Nobcha/R909-SINAD/C401_FFT@433MHz.jpg

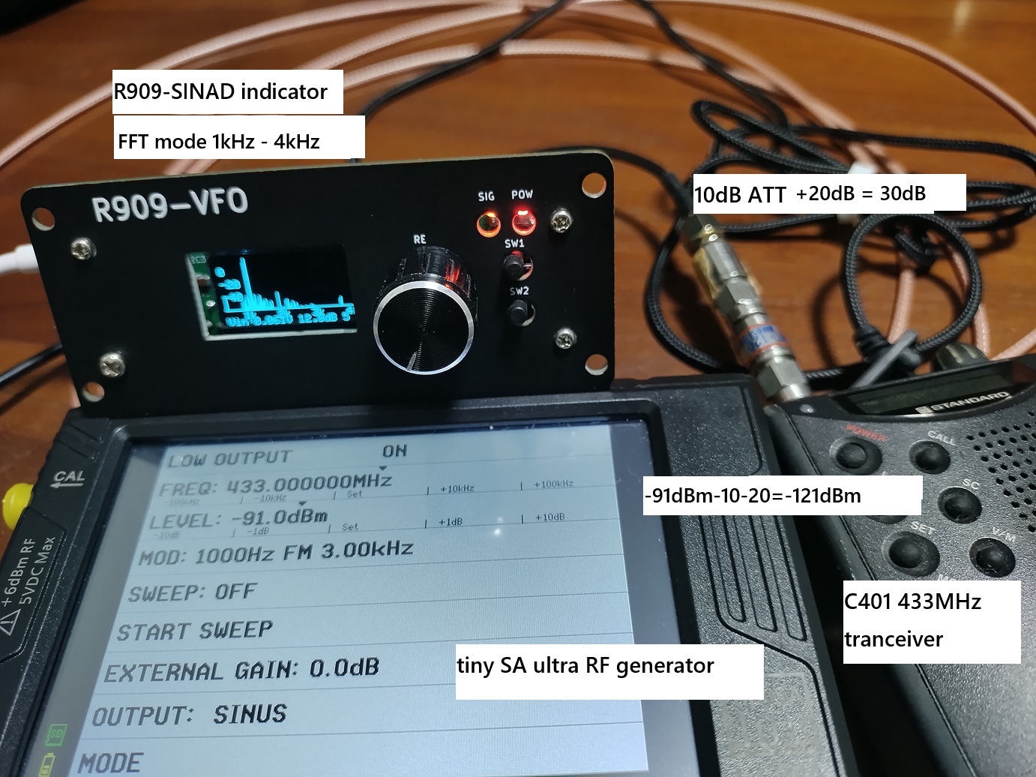
C401_FFT@433MHz.jpg
