Nobcha/R909-SINAD/C401_SINAD@433MHz_.jpg

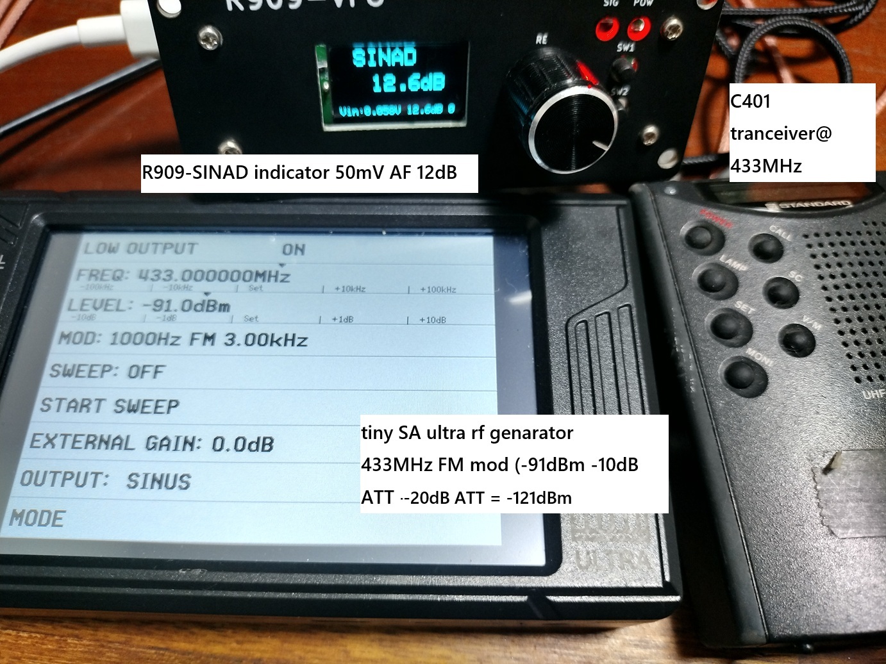
C401_SINAD@433MHz_.jpg
