Nobcha/R909-SINAD/SINAD_block.jpg

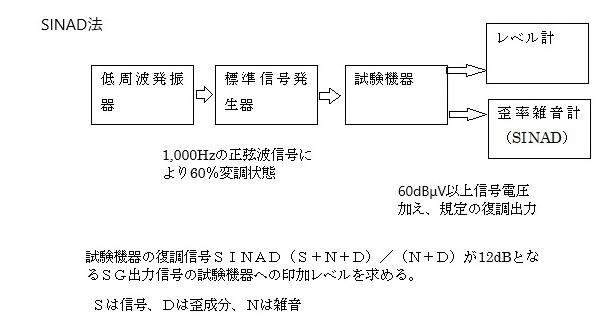
SINAD_block.jpg
