Nobcha/R909-SINAD/R909-VFO_ESP32_SCM.pdf

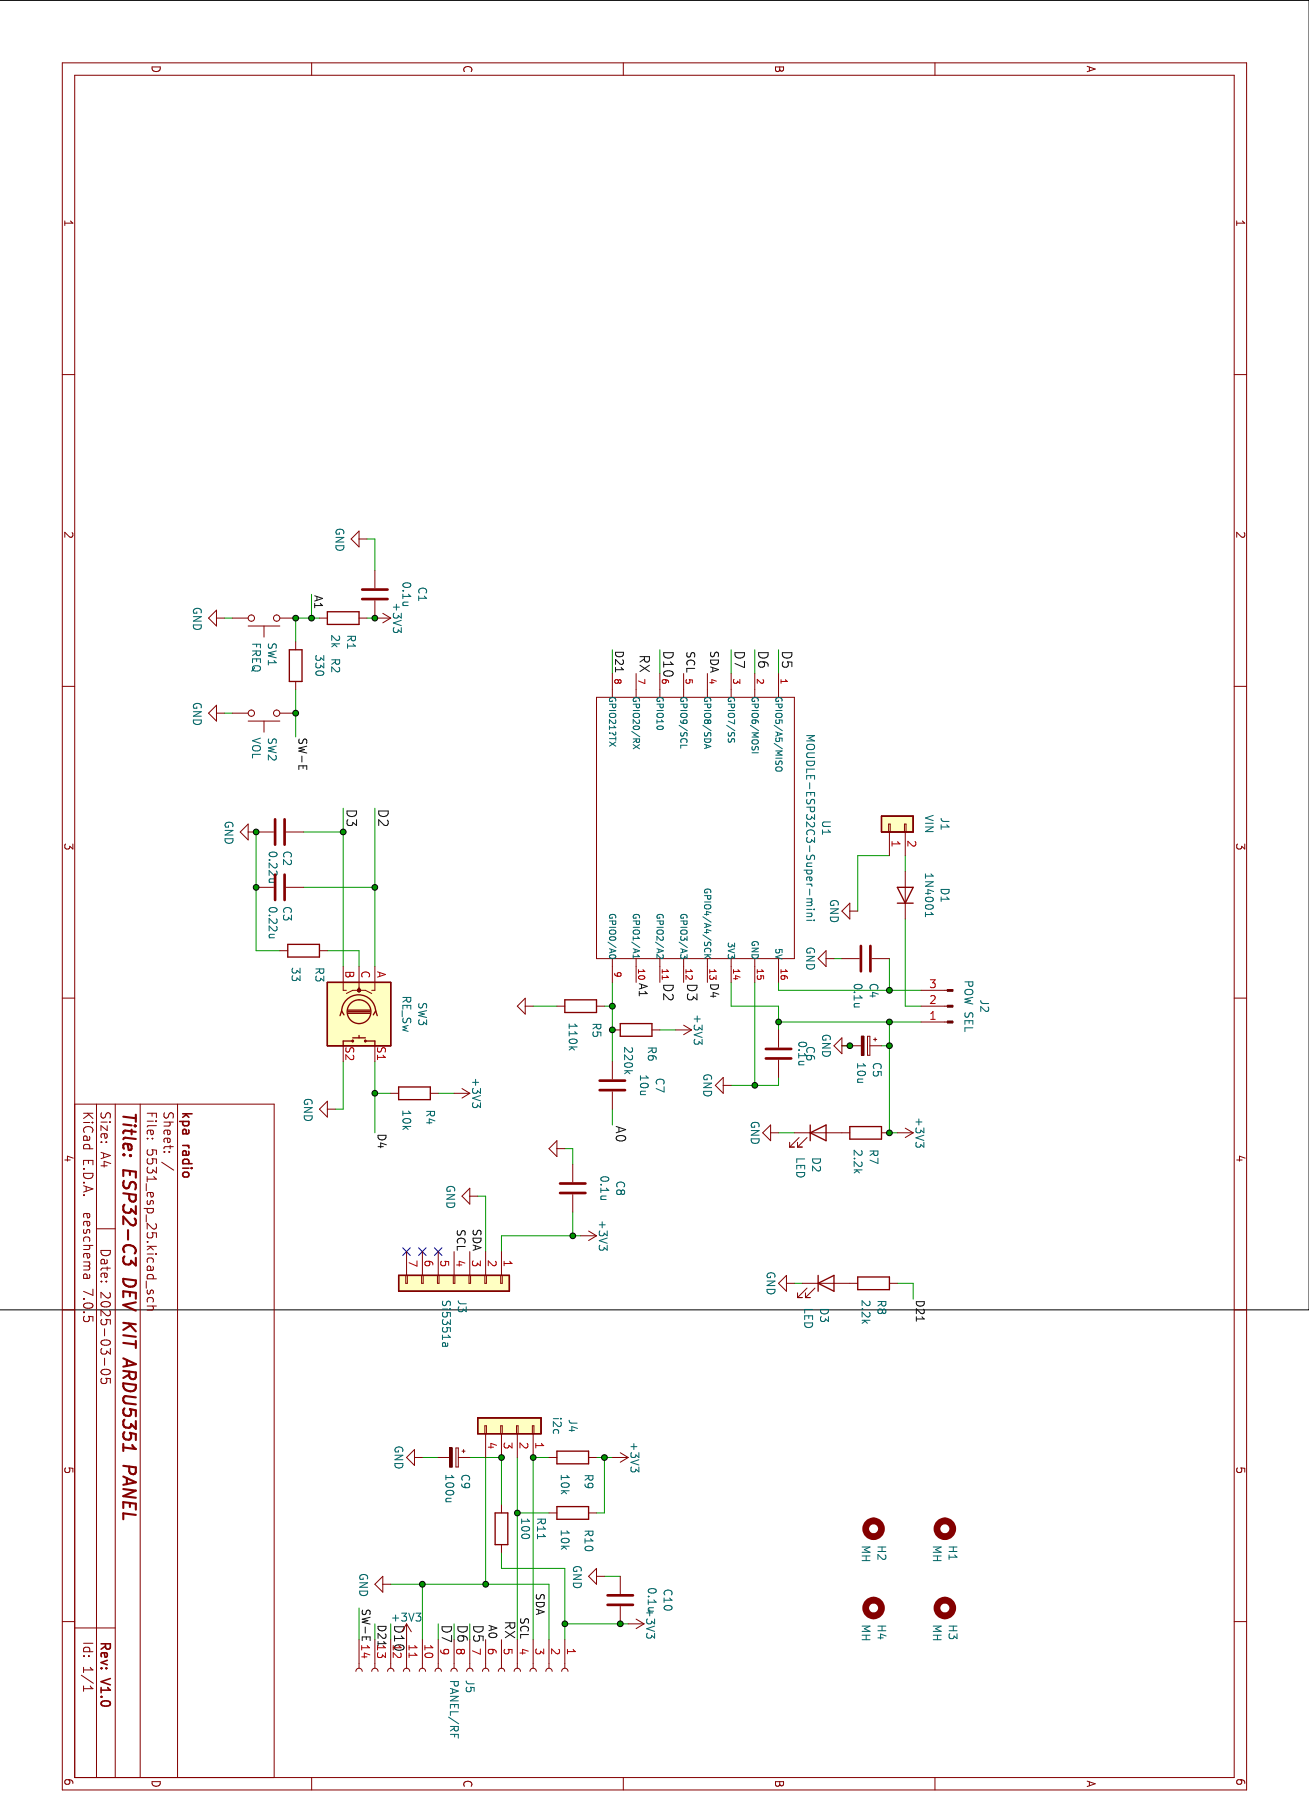
[picture p5: page 1]
