Nobcha/R909-SINAD/(commit log)

2025-06-09 Update README.md
    R909-ESP基板を使ったSINAD表示器試作
2025-06-09 R909-ESP schematic
    ESP32-C3 DEV kit Super Mini+OLED＋RotaryEncoder
2025-06-09 Diagnostic sketch for R909-ESP PCB assy
    This sketch is prepared for testing R909-ESP PCB assembled. There are several items for i2c testing and SW testing.
2025-06-09 Notch filter code
    Open source of the filter code from VST web.
2025-06-10 For reference @ chatGPT
    The current debugging version of R909-SINAD. @2025.06.10 16:40
2025-06-15 The currently ino
    IIR notch function is well. There are 5 kinds of display as SINAD value, input wave, notched wave, input FFT, notched FFT, and inner parameters.
2025-06-18 The currently ino debugged well
    10kHz sampling 512 points, 1kHz notch IIR function, RMS, WAVE & FFT display with tiny scale,
2025-06-22 R909-SINAD PCB Geber data
    PCB production data for PCB vendor
2025-06-22 R909-SINAD indicator BOM
    BOM data
